billhsu/MiniQ/Hardware/PCB.PNG

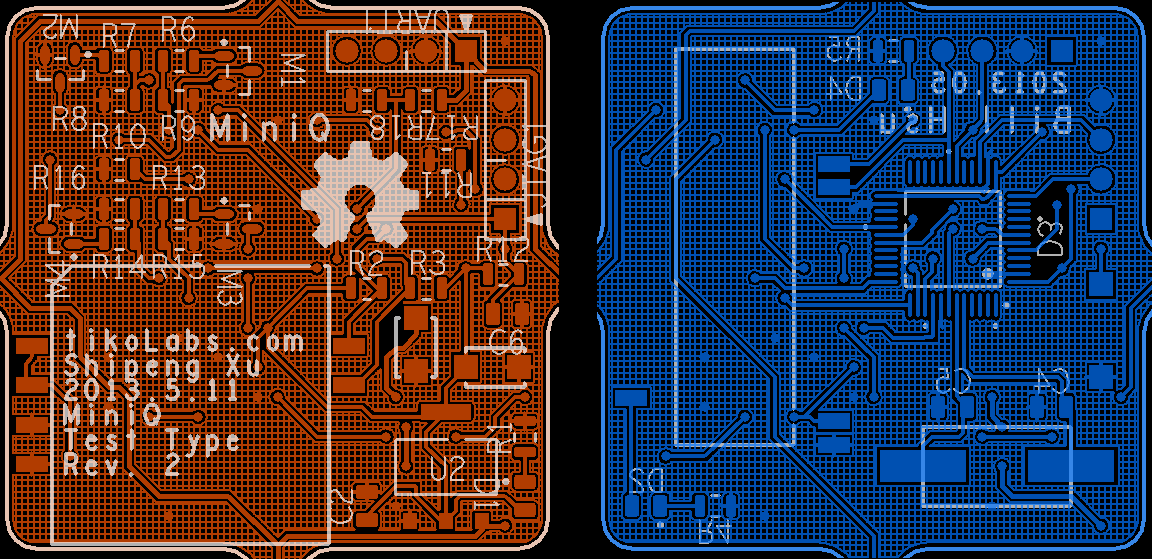
Hardware/PCB.PNG
