billhsu/MiniQ/Hardware/SCHEMATIC_IMU.pdf

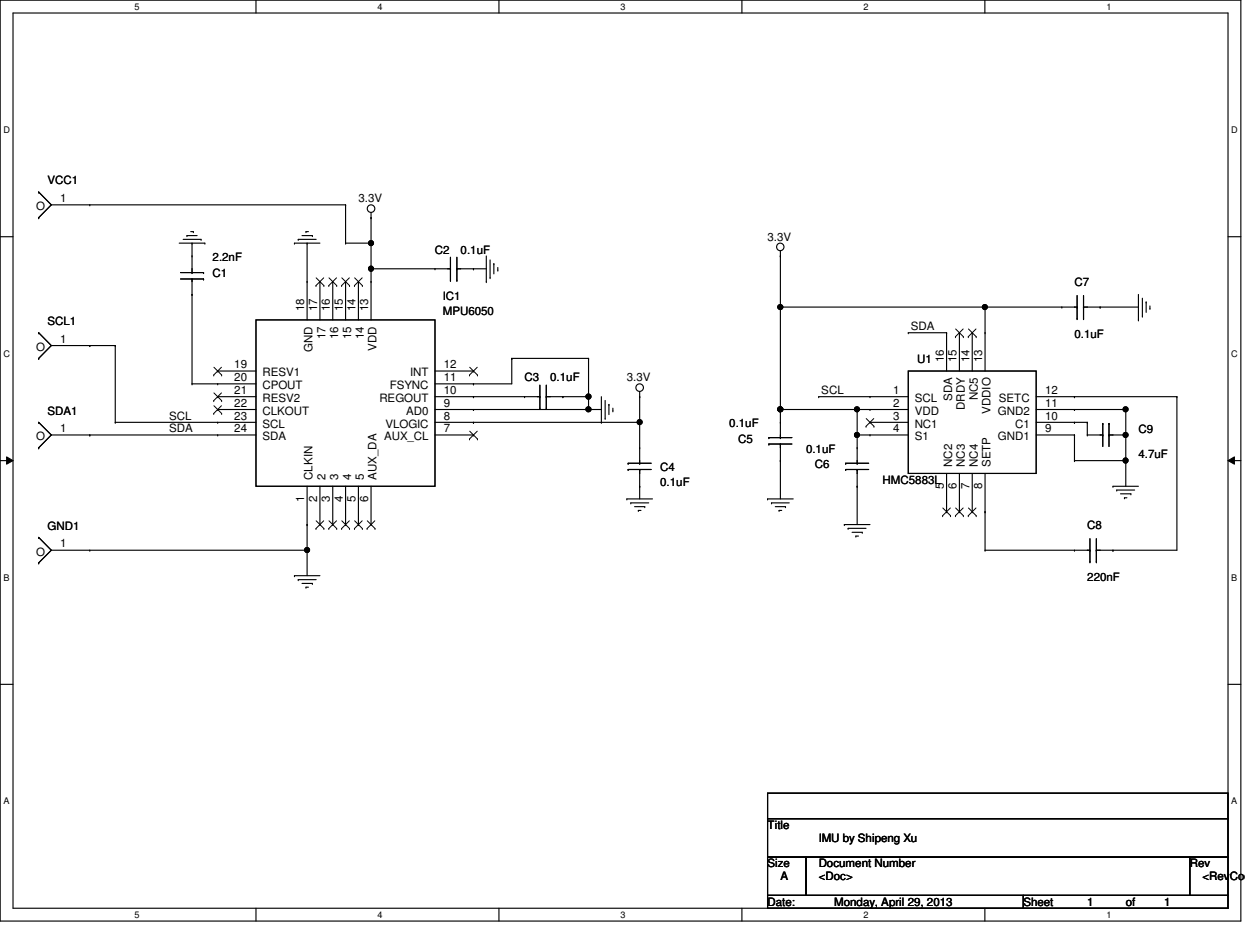
[picture p8: page 1]

IMU by Shipeng Xu
