billhsu/MiniQ/Hardware/SCHEMATIC_MiniQ_TestType.pdf

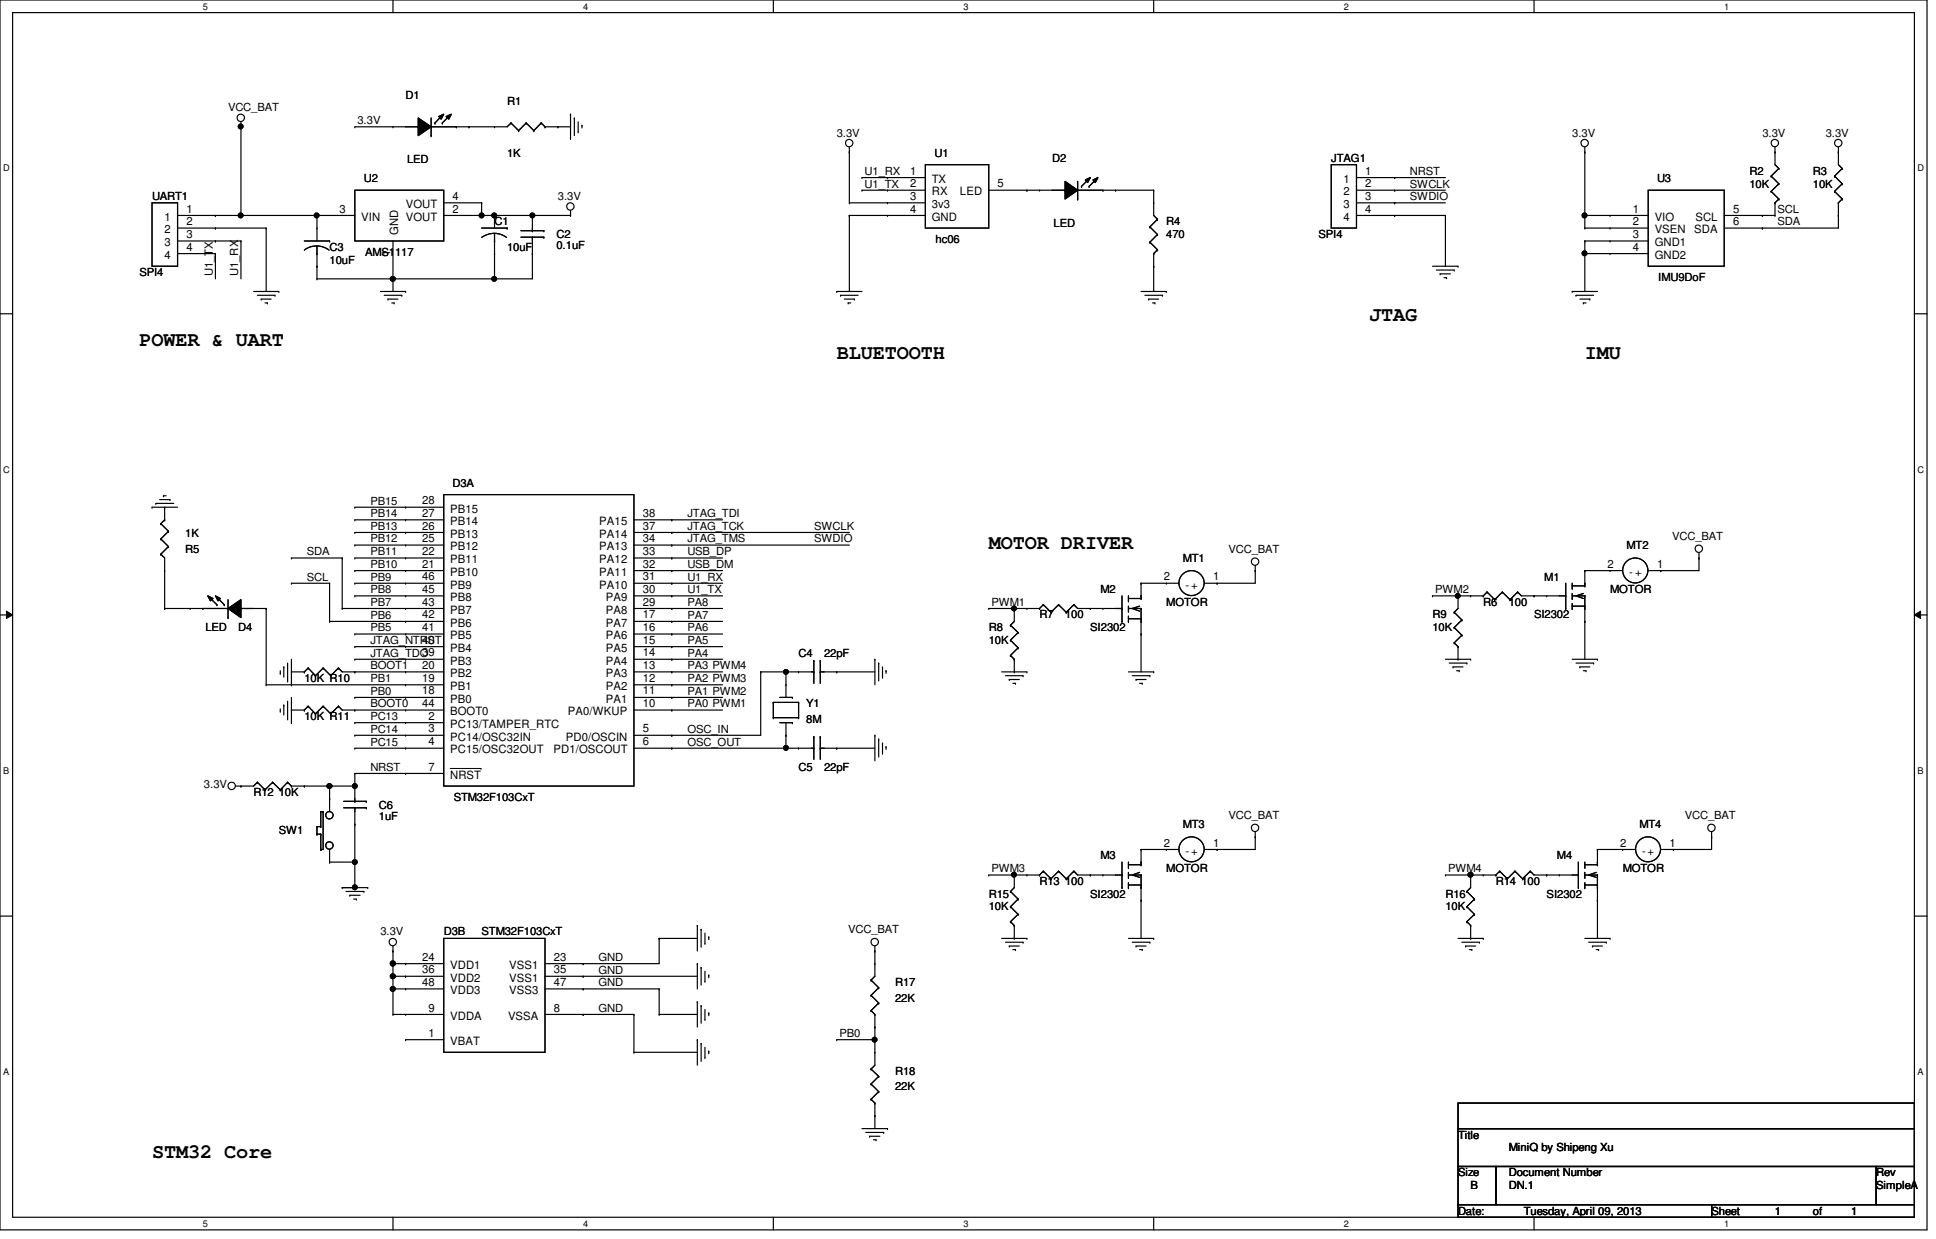
[picture p9: page 1]

MiniQ by Shipeng Xu
