billhsu/MiniQ/Hardware/SCHEMATIC_MiniQ.pdf

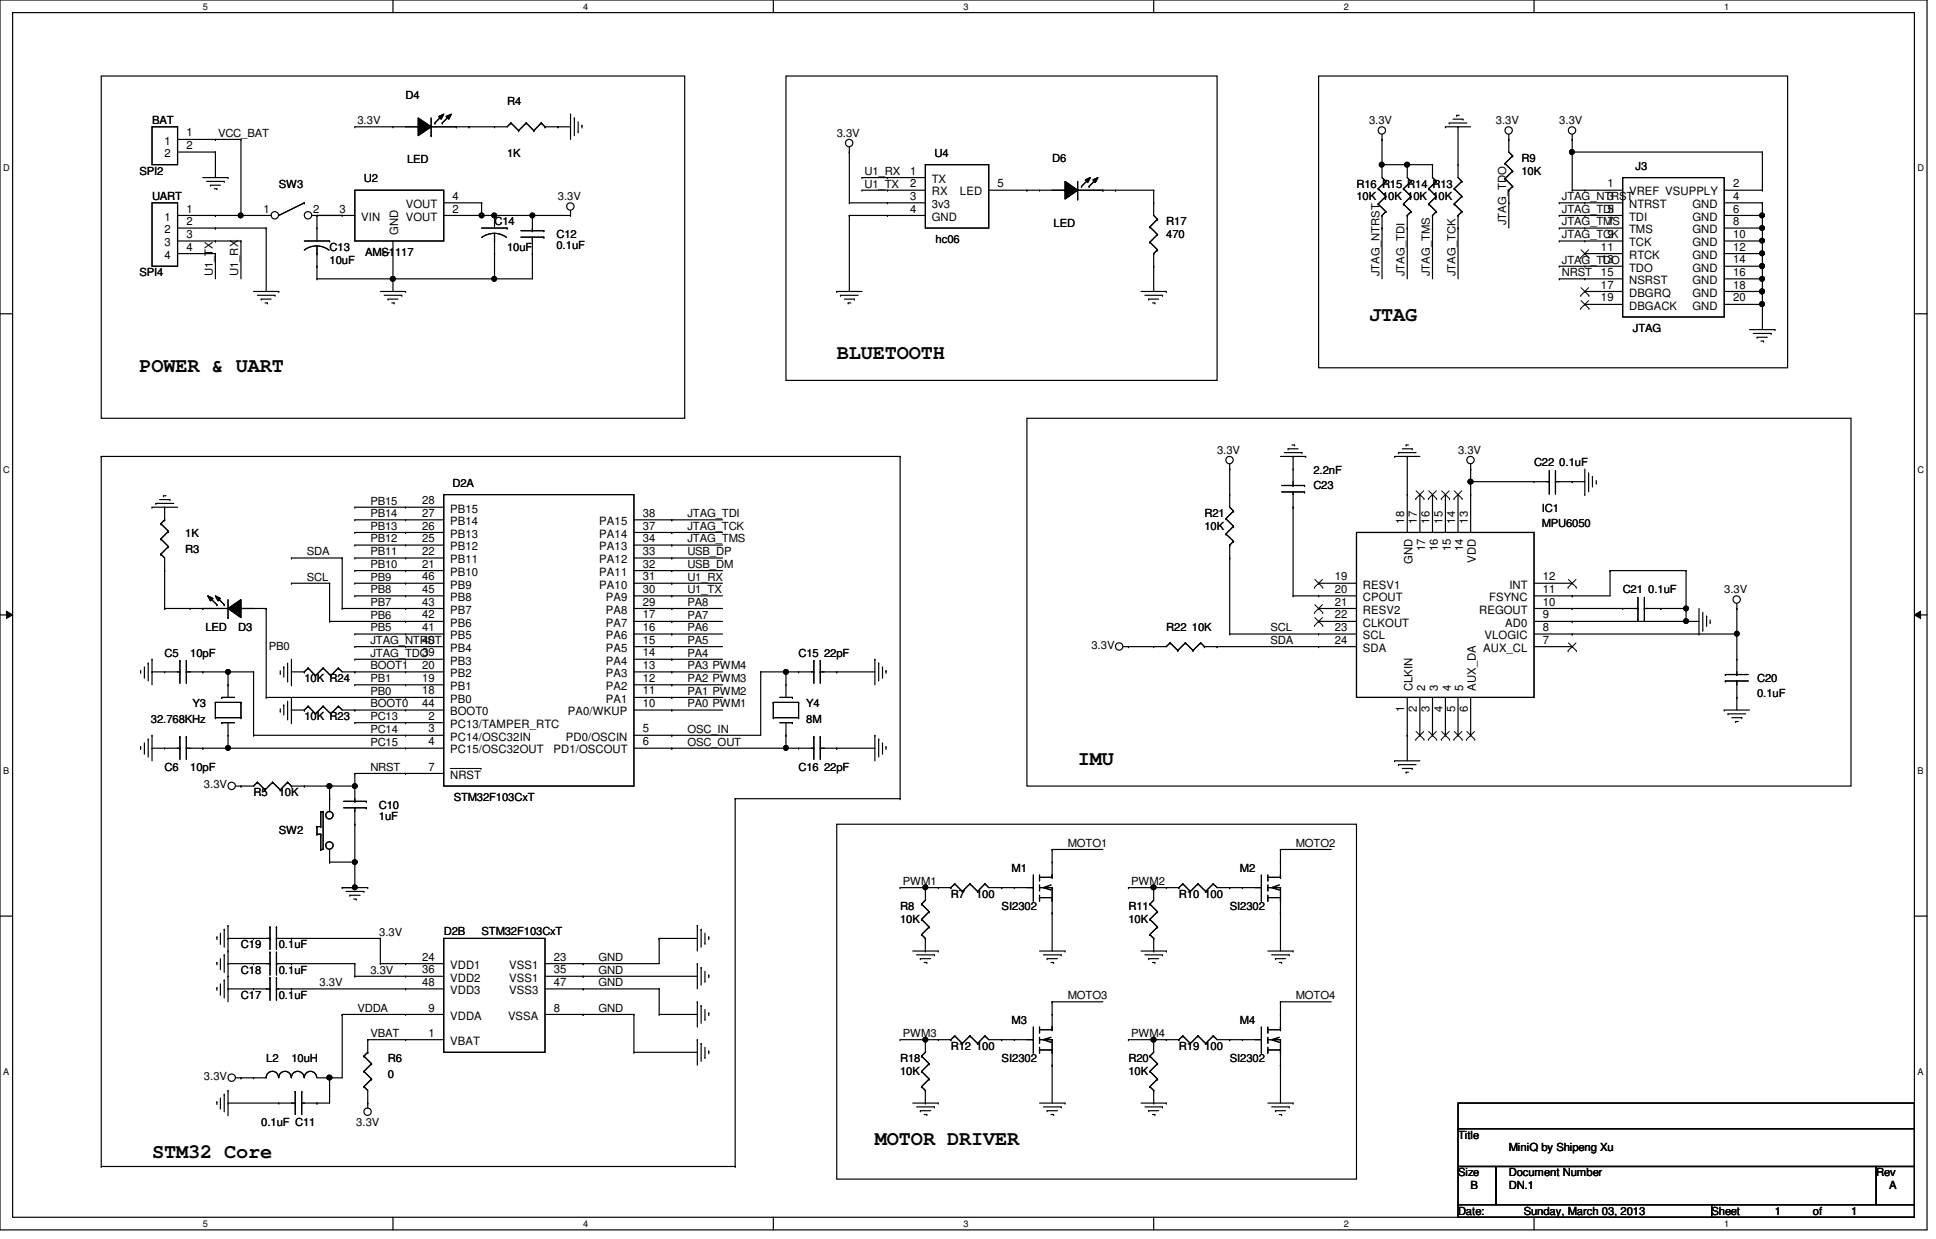
[picture p10: page 1]

MiniQ by Shipeng Xu
