billhsu/MiniQ/MiniQ/SRC/define.h

#ifndef  _DEFINE_H_
#define	 _DEFINE_H_

#define CLI()      __set_PRIMASK(1)  
#define SEI()      __set_PRIMASK(0)

#define BYTE0(dwTemp)       (*(char *)(&dwTemp))
#define BYTE1(dwTemp)       (*((char *)(&dwTemp) + 1))
#define BYTE2(dwTemp)       (*((char *)(&dwTemp) + 2))
#define BYTE3(dwTemp)       (*((char *)(&dwTemp) + 3))



#define MPU6050_READRATE			1000
#define MPU6050_READTIME			0.001
#define EE_6050_ACC_X_OFFSET_ADDR	0
#define EE_6050_ACC_Y_OFFSET_ADDR	1
#define EE_6050_ACC_Z_OFFSET_ADDR	2
#define EE_6050_GYRO_X_OFFSET_ADDR	3
#define EE_6050_GYRO_Y_OFFSET_ADDR	4
#define EE_6050_GYRO_Z_OFFSET_ADDR	5

#endif
