billhsu/MiniQ/MiniQ/SRC/Extern_Variable.h

#ifndef _EXTERN_VARIABLE_H_
#define _EXTERN_VARIABLE_H_

////////////////////////////////////////////////////////////////////////////////

////////////////////////////////////////////////////////////////////////////////
//系统
extern uint8_t SYS_INIT_OK;					//系统初始化完成标志
extern uint8_t FLY_ENABLE;						//飞行开关
extern uint8_t GYRO_OFFSET_OK;					//稳态误差计算完成标志
extern uint8_t ACC_OFFSET_OK;
extern uint8_t IIC_ERROR_CNT;					//iic错误计数器,每次tim3中断加1,如果读取成功置0
extern uint8_t	I2C2_BUSY;
volatile extern uint8_t 	MPU6050_I2CData_Ready;		//mpu6050读取完成标志,=1表示读取完成
extern uint32_t While1_Lasttime;						//存储while循环的时间


////////////////////////////////////////////////////////////////////////////////
//传感器
typedef struct int16_xyz{
				int16_t X;
				int16_t Y;
				int16_t Z;}S_INT16_XYZ;
typedef union {int16_t D[3];
				S_INT16_XYZ V;
				}U_INT16_XYZ;

extern S_INT16_XYZ 	HMC5883L_LAST,MPU6050_ACC_LAST,MPU6050_GYRO_LAST;		//最新一次读取值
extern S_INT16_XYZ 	GYRO_OFFSET,ACC_OFFSET;			//零漂
////////////////////////////////////////////////////////////////////////////////
//IMU
typedef struct float_xyz{
				float X;
				float Y;
				float Z;}S_FLOAT_XYZ;
typedef union {float D[3];
				S_FLOAT_XYZ V;
				}U_FLOAT_XYZ;
typedef struct float_angle{
				float Roll;
				float Pitch;
				float Yaw;}S_FLOAT_ANGLE;

extern S_FLOAT_XYZ ACC_F,GYRO_F;	//当次转换结果ACC单位为G,GYRO单位为度/秒
extern S_FLOAT_XYZ GYRO_I[3];		//陀螺仪积分
extern S_FLOAT_XYZ EXP_ANGLE;		//期望角度
extern S_FLOAT_XYZ DIF_ANGLE;		//期望角度与实际角度差
extern S_FLOAT_ANGLE Q_ANGLE;		//四元数计算出的角度
extern S_INT16_XYZ ACC_AVG,GYRO_AVG;		//滑动窗口滤波后的ACC平均值和处理后的gyro值
extern uint32_t	IMU_CYCTIME;	//两次读取systick时的计数值差值

#endif
