billhsu/MiniQ/(commit log)

2013-01-26 Add UART and Delay driver
2013-01-27 Update mpu6050 and i2c driver
2013-01-27 Update HMC5883l Driver
2013-01-27 Add IMU, but it has bugs :(
    [imu.c, imu.h, main.c, mpu6050.c]
2013-02-04 Add Gyro offset
2013-02-05 Add 3d view, adjust IMU algorithm
2013-02-06 Update Viewer,STM32 IMU and MPU6050 Driver. Code is neater.
2013-02-06 Add timer driver. Change stm32f10x_lib.h to stm32f10x.h
2013-02-06 Adjust IMU
2013-02-08 Haha! Finally the IMU AHRS algorithm is steady.
2013-03-02 Add circuit schematic
2013-03-03 Update Circuit
2013-04-09 Add Test Type Schematic
2013-04-26 Add IMU circuit
2013-04-30 Update IMU Schematic
2013-05-05 Add motor driver
2013-05-13 Add PCB
2013-05-25 Fix timer bug
2013-05-26 Fix bug in tick timer
    [imu.c, main.c]
2013-05-26 Add Control algorithm. test stage.
2013-05-27 Add PID controller
2013-05-28 Add yaw pitch roll instructions
2013-05-28 Modify PID control algorithm.
2013-05-28 Change Kd in PID
2013-05-29 Change PID algorithm
2013-05-29 adjust PID
2013-06-01 Optimize i2c driver
2013-06-03 IMU update
2013-06-15 adjust imu pid
2013-06-19 change i2c driver
2013-06-22 Add yaw control.
2013-06-27 Add compass in IMU
2013-06-27 Fix bug in IMU
    [UARTs.c, control.c, imu.c, main.c]
2013-06-30 clean code
    [proguard.cfg]
2013-08-17 add UsbSerialLibrary
    [proguard.cfg]
